SirBlaze10/Conversor-CC-CC-Buck-Boost-Interleaved/index.md

Neste projeto, foi efetuado o design, simulação, montagem e teste do protótipo de um Conversor CC-CC Bidirecional com Topologia Interleaved.

Na pasta PCB, encontra-se o esquemático e layout da placa de circuito impresso desenvolvida, tendo para tal fim sendo utilizado o PADS PCB Design Software da Mentor Graphics.

Na pasta Simulação PSIM, encontra-se a simulação do conversor com recurso ao software de simulação PSIM, desenvolvido pela Powersim inc., 
sendo que este possui inúmeras características indispensáveis para uma rigorosa simulação, desde uma biblioteca com um vasto número de componentes, 
até a possibilidade de criar algoritmos em linguagem C para sistemas de controlo.

Todo o código desenvolvido para o microprocessador utilizado (STM32F767ZIT6), encontra-se na pasta Código.

Todo o registo fotográfico, desde a bancada de teste, até à montagem do protótipo, encontra-se na pasta registo fotográfico.

Por fim, as duas apresentações públicas efetuadas no âmbito deste projeto, encontram-se na pasta apresentação, enquanto que o relatório do projeto encontra-se na pasta relatório.
