SirBlaze10/Conversor-CC-CC-Buck-Boost-Interleaved/Apresentação/Apresentação final PI.pdf

## UNIVERSIDADE DO MINHO

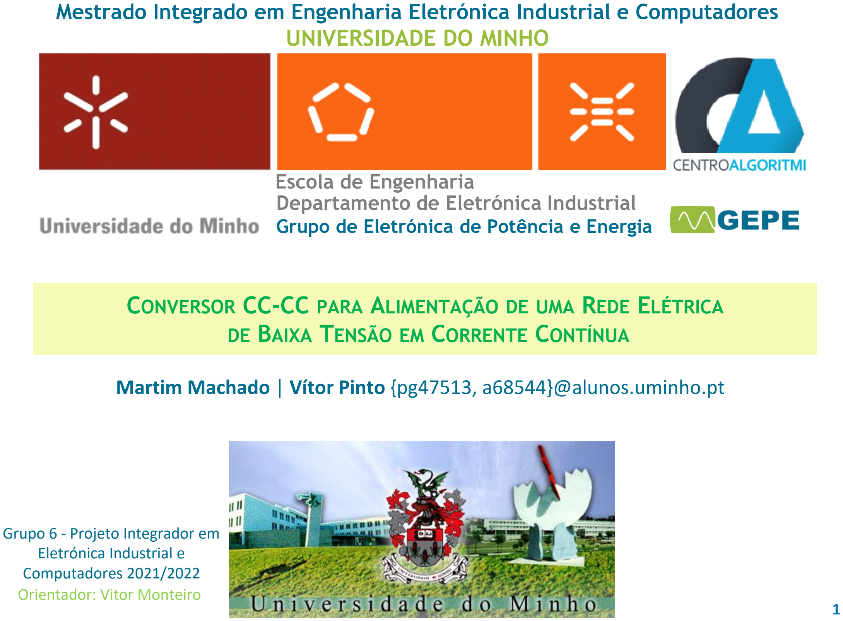
[picture p51: page 1]

Mestrado Integrado em Engenharia Eletrónica Industrial e Computadores

### Escola de Engenharia Departamento de Eletrónica Industrial

1

Grupo de Eletrónica de Potência e Energia

CONVERSOR CC-CC PARA ALIMENTAÇÃO DE UMA REDE ELÉTRICA DE BAIXA TENSÃO EM CORRENTE CONTÍNUA

## Martim Machado | Vítor Pinto {pg47513, a68544}@alunos.uminho.pt

Grupo 6 - Projeto Integrador em Eletrónica Industrial e
Computadores 2021/2022
Orientador: Vitor Monteiro

2

## ÍNDICE

## - Resumo e atualização das fases anteriores (análise e design)

## - Topologia Adotada - Simulações computacionais

## - Descrição dos detalhes de implementação relevantes

## - Implementação prática - Sistema de controlo (sensores, drivers, microprocessador, …) - Circuito de potência - Esquemático e design da placa para o sistema implementado - Montagem do protótipo

## - Apresentação e discussão de testes e resultados

## - Método de validação - Resultados em malha aberta - Resultados em malha fechada

## - Tarefas Realizadas - Conclusões do trabalho

3

# Componente teórica

4

## RESUMO E ATUALIZAÇÃO DAS FASES ANTERIORES (ANÁLISE E DESIGN)

## - Menor ripple corrente de saída - Correntes nas bobinas desfasados em 180° - Elevado rendimento

# - Topologia Adotada

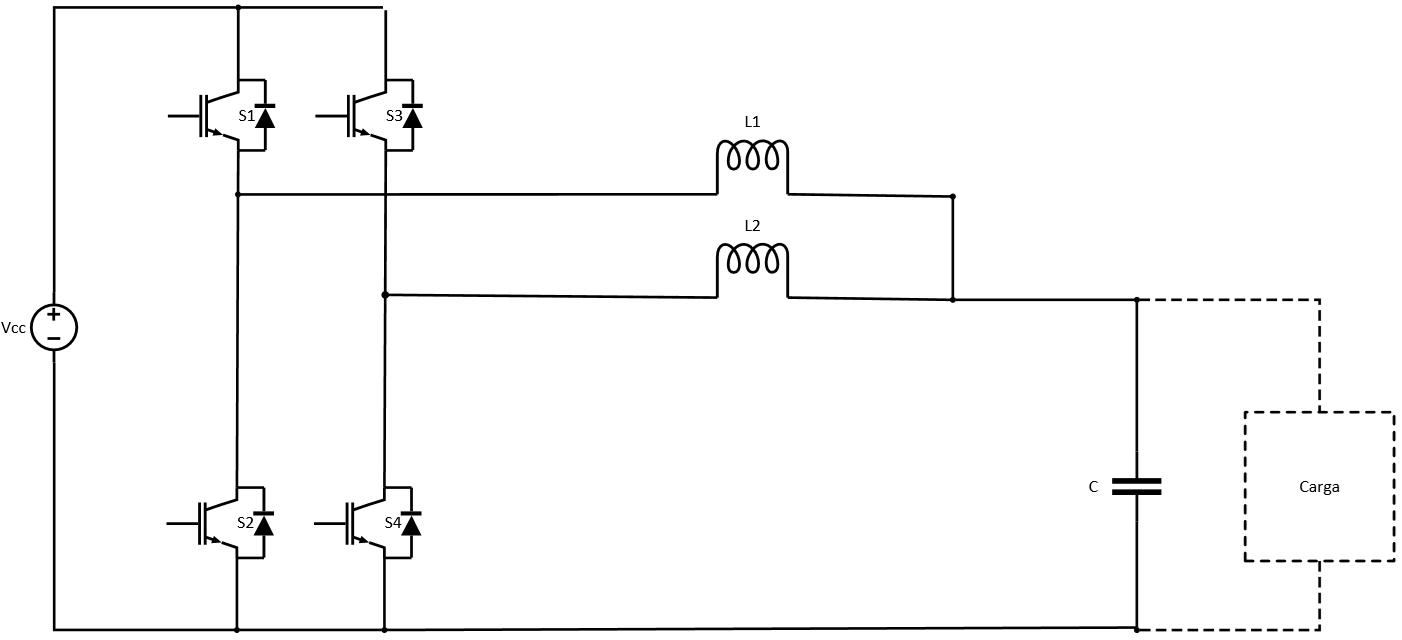
[picture p52: figure]

5

## RESUMO E ATUALIZAÇÃO DAS FASES ANTERIORES (ANÁLISE E DESIGN)

## - Peso e tamanho reduzidos

# - Topologia Adotada

## …foi usada uma bobina com núcleo com acoplamento mútuo…

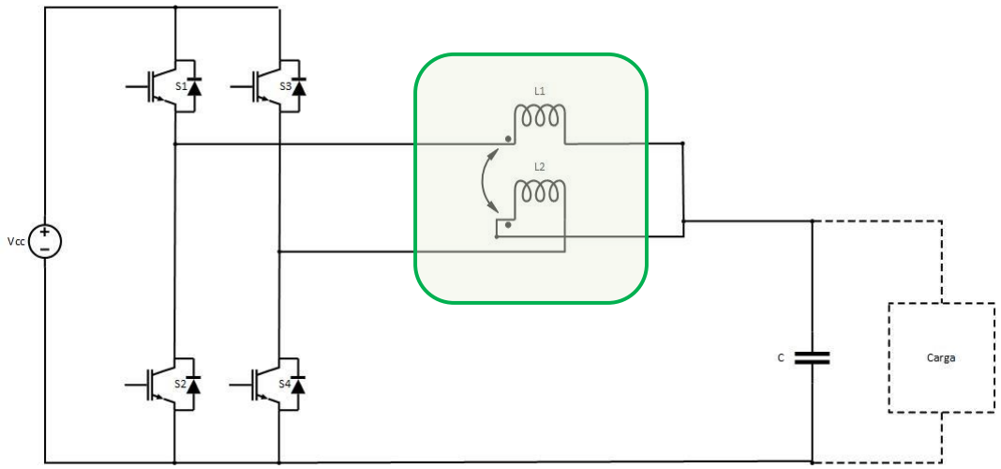
[picture p53: figure]

6

# Validação Computacional

## RESUMO E ATUALIZAÇÃO DAS FASES ANTERIORES (ANÁLISE E DESIGN)

# - Simulações computacionais

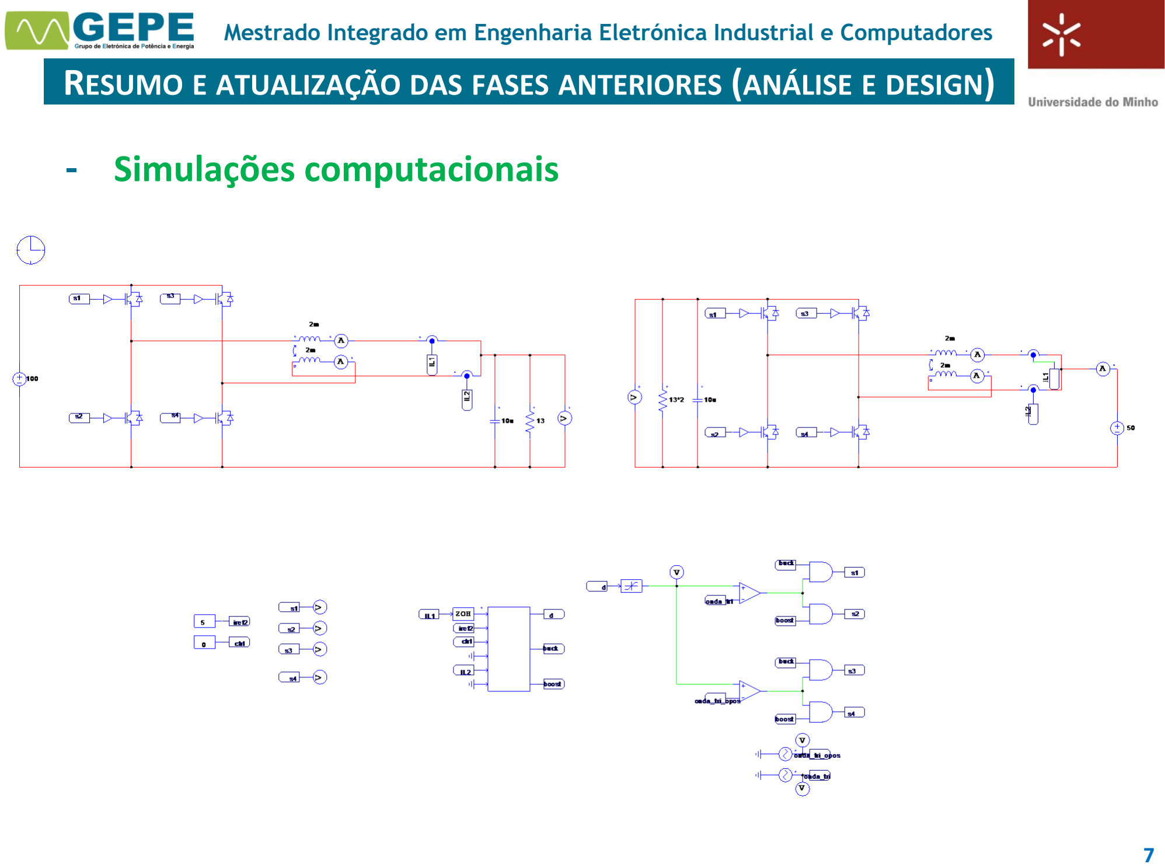
[picture p54: page 7]

7

8

## RESUMO E ATUALIZAÇÃO DAS FASES ANTERIORES (ANÁLISE E DESIGN)

## - Previsão comportamento do sistema/projeto - Maior segurança na validação experimental - Software utilizado: PSIM (Powersim Inc.) - Controlador PI

# - Simulações computacionais

## D = kp(iref − iL) + ki න( iref − iL)dt

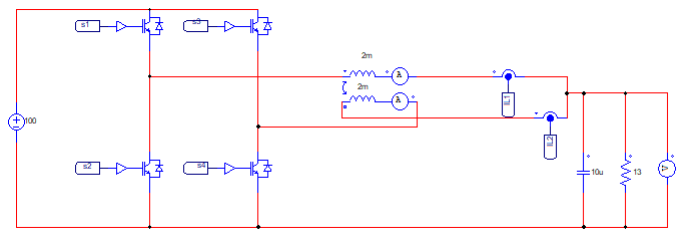
[picture p55: figure]

9

## RESUMO E ATUALIZAÇÃO DAS FASES ANTERIORES (ANÁLISE E DESIGN)

## - Previsão comportamento do sistema/projeto - Maior segurança na validação experimental - Software utilizado: PSIM (Powersim Inc.) - Controlador PI

# - Simulações computacionais

## …corrente em cada bobina controlada de forma individual…

10

## RESUMO E ATUALIZAÇÃO DAS FASES ANTERIORES (ANÁLISE E DESIGN)

## - Escrita de algoritmos em linguagem C - Simula o funcionamento do microprocessador

# - Simulações computacionais - Bloco C

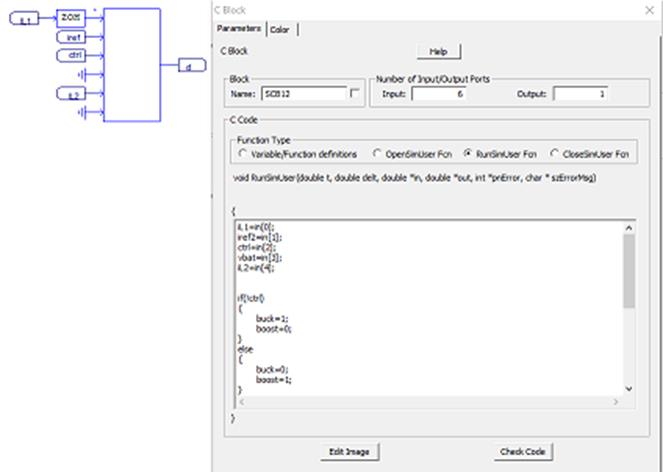
[picture p56: figure]

11

## RESUMO E ATUALIZAÇÃO DAS FASES ANTERIORES (ANÁLISE E DESIGN)

## - Lógica combinacional (selecionar buck ou boost) - Obtidos sinais de PWM desfasados em 180°

# - Simulações computacionais - Circuito de controlo

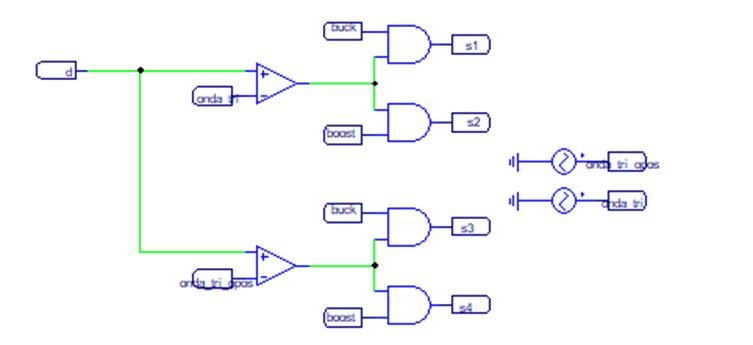
[picture p57: figure]

12

## RESUMO E ATUALIZAÇÃO DAS FASES ANTERIORES (ANÁLISE E DESIGN)

## - Frequência de amostragem 100 kHz - Frequência de comutação 50 kHz

# - Simulações computacionais - Sistema de controlo

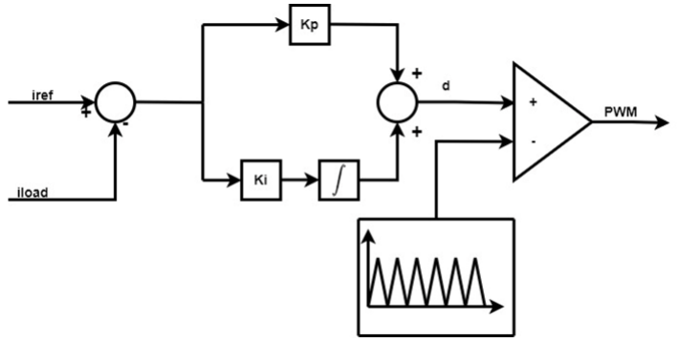
[picture p58: figure]

## RESUMO E ATUALIZAÇÃO DAS FASES ANTERIORES (ANÁLISE E DESIGN)

# - Simulações computacionais

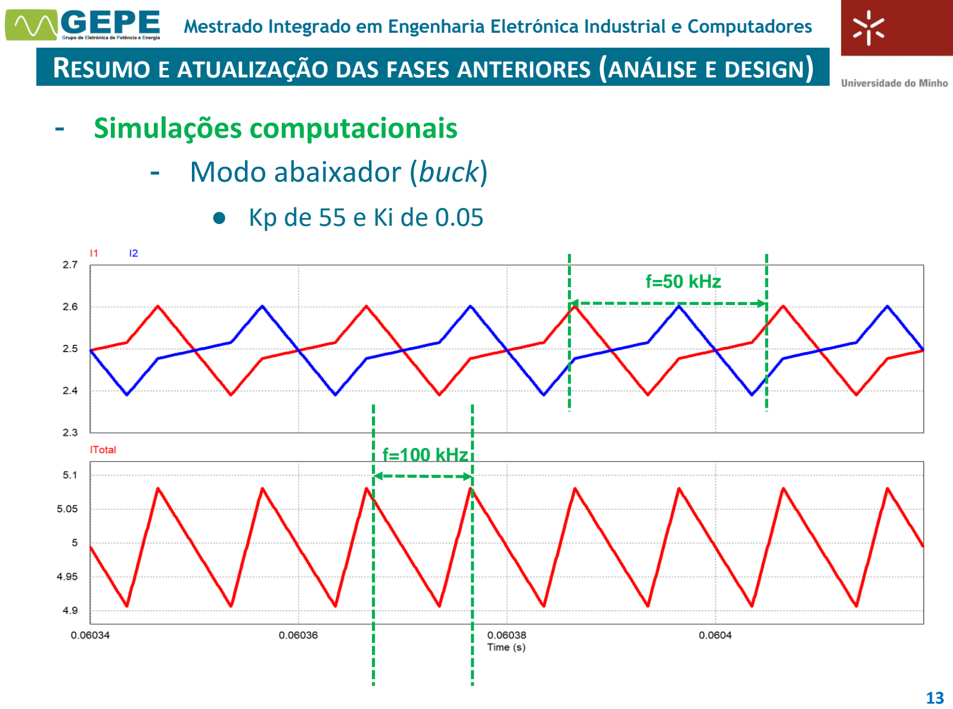
[picture p59: page 13]

13

## - Kp de 55 e Ki de 0.05

# - Modo abaixador (buck)

f=100 kHz

f=50 kHz

## RESUMO E ATUALIZAÇÃO DAS FASES ANTERIORES (ANÁLISE E DESIGN)

# - Simulações computacionais

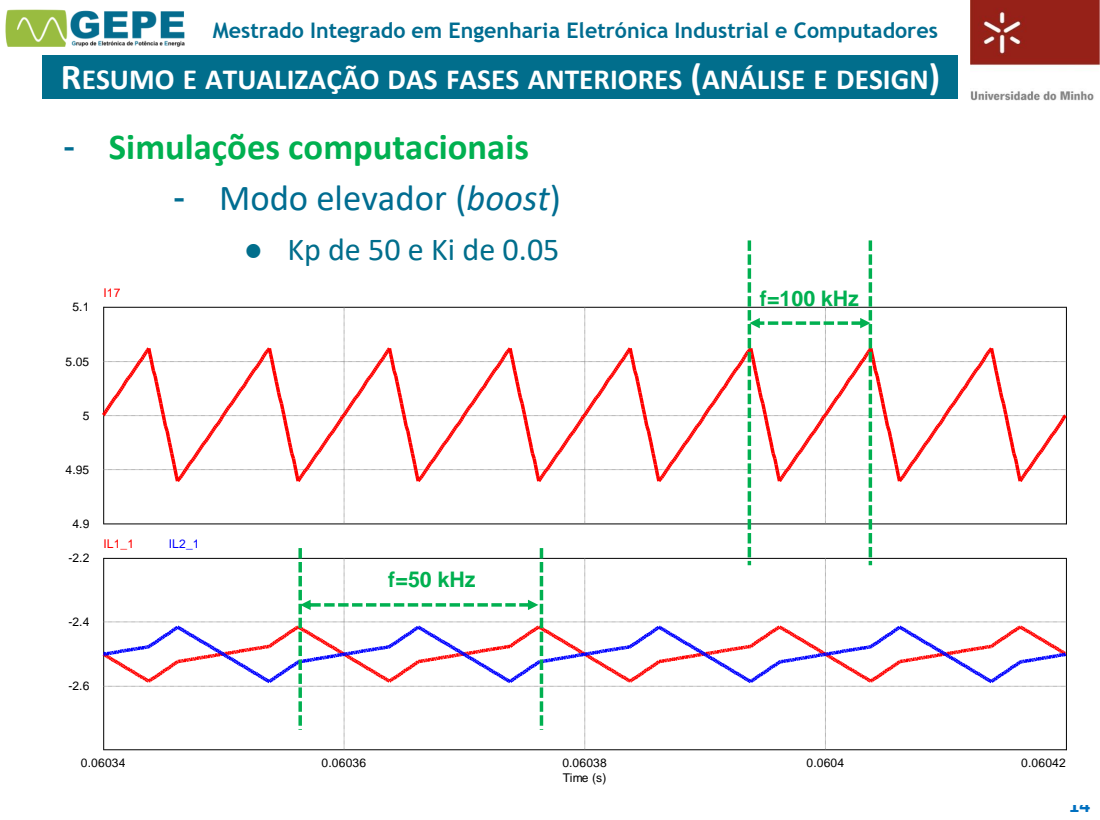
[picture p60: page 14]
Time (s); f=100 kHz; f=50 kHz

- Modo elevador (boost)

15

# Implementação Prática

## DESCRIÇÃO DOS DETALHES DE IMPLEMENTAÇÃO RELEVANTES

## - Sistema de controlo

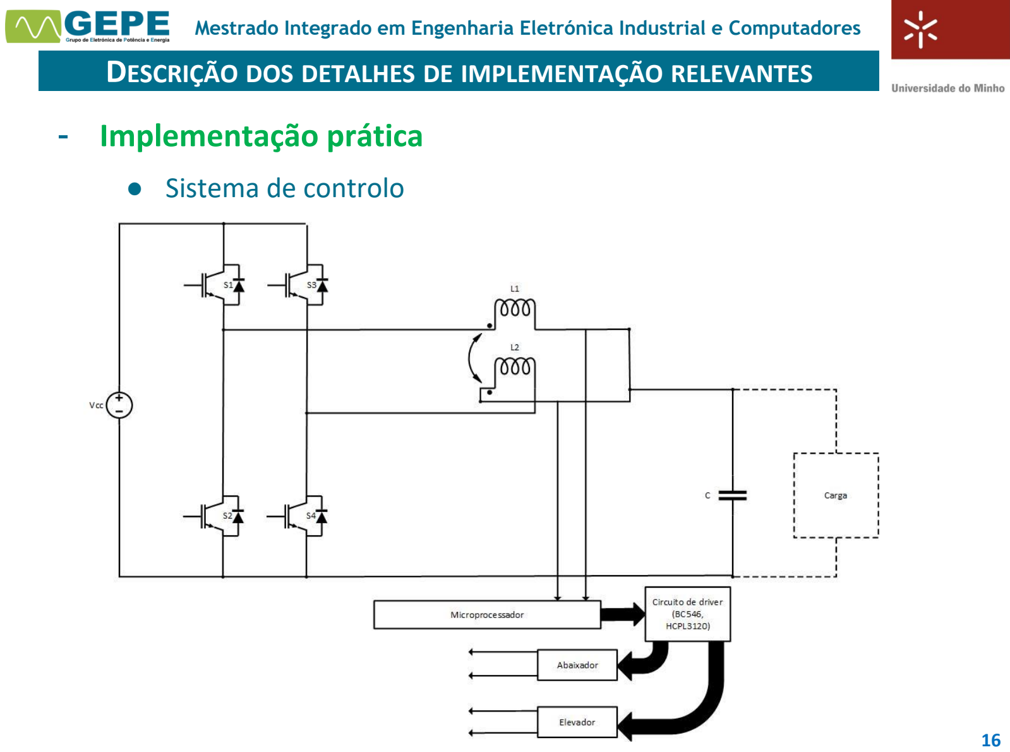
[picture p61: page 16]

16

## - Sistema de potência

# - Implementação prática

17

## DESCRIÇÃO DOS DETALHES DE IMPLEMENTAÇÃO RELEVANTES

## - Sensor efeito de Hall LA 100-P/SP13 - Medição de correntes CC e CA até 100 A - Corrente 1000 vezes inferior no secundário - 10 Ω < (R+Rm) < 65 Ω

# - Sistema de controlo - Sensores de corrente

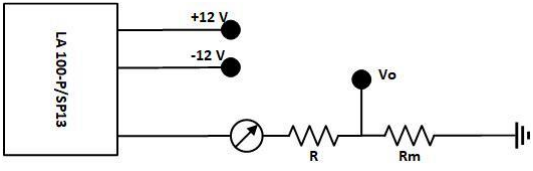
[picture p62: figure]

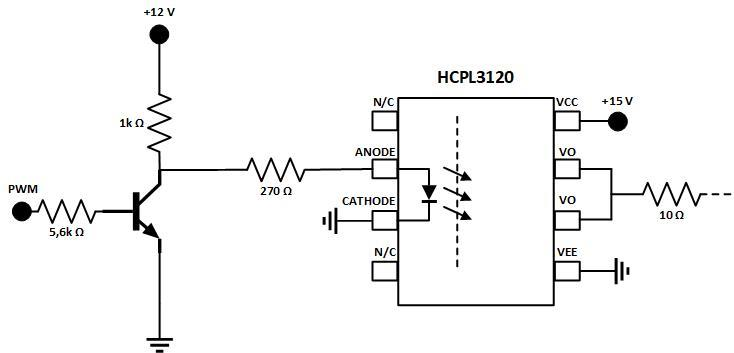
[picture p63: figure]

18

## DESCRIÇÃO DOS DETALHES DE IMPLEMENTAÇÃO RELEVANTES

## - Transístor bipolar BC546 - Optoacoplador HCPL3120 - Sinal de PWM com corrente de 10 mA (input HCPL3120) - Lógica inversora

# - Sistema de controlo - Circuito de driver

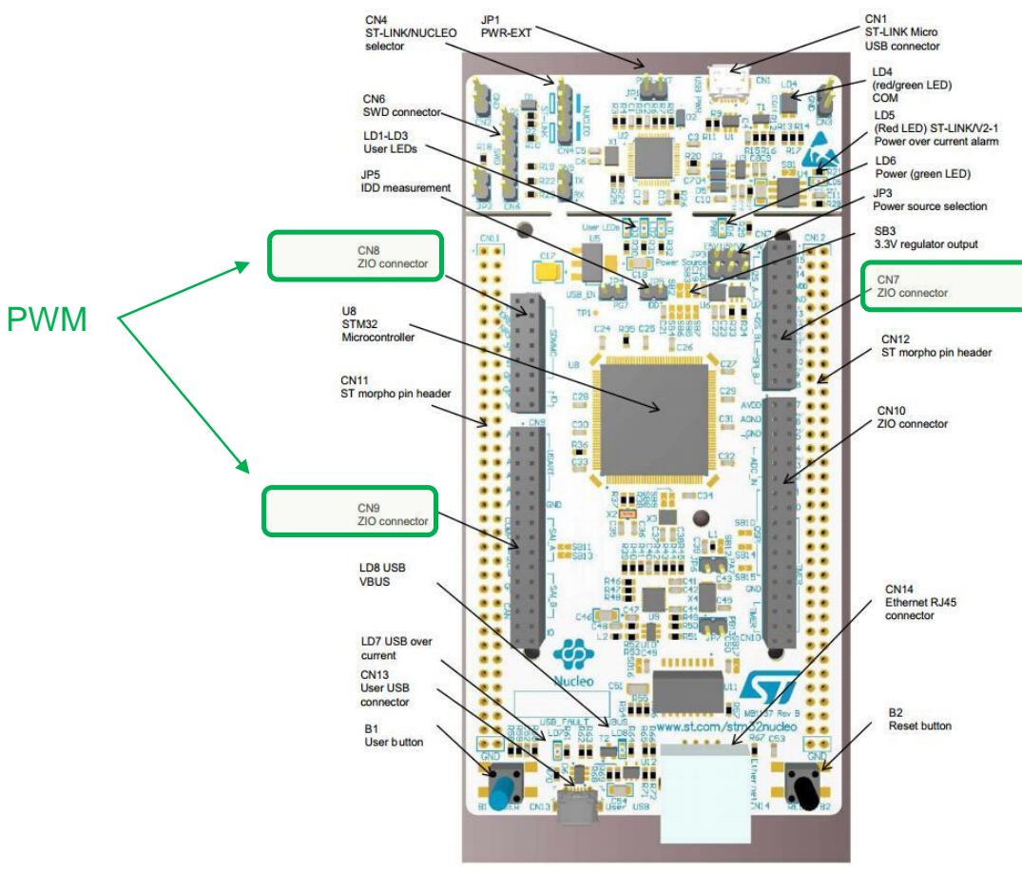
[picture p64: figure]
PWM

19

## DESCRIÇÃO DOS DETALHES DE IMPLEMENTAÇÃO RELEVANTES

# - Microprocessador - STM32F767ZIT6

ADC


20

## DESCRIÇÃO DOS DETALHES DE IMPLEMENTAÇÃO RELEVANTES

# - Sistema de controlo - Fluxograma da rotina de controlo

21

## DESCRIÇÃO DOS DETALHES DE IMPLEMENTAÇÃO RELEVANTES

# - Circuito de potência

## - IGBT com referência FGA25N120AN - Bobinas de acoplamento mútuo de 2 mH | 20 A - Colocação de dissipador (10 cm x 10 cm) - Condensadores de 15 µF 800 V - Tensão input máxima: 150 V - Tensão output máxima: 150 V - Potência máxima: 2,4 kW

## DESCRIÇÃO DOS DETALHES DE IMPLEMENTAÇÃO RELEVANTES

# - Esquemático e Design da Placa para o Sistema Implementado

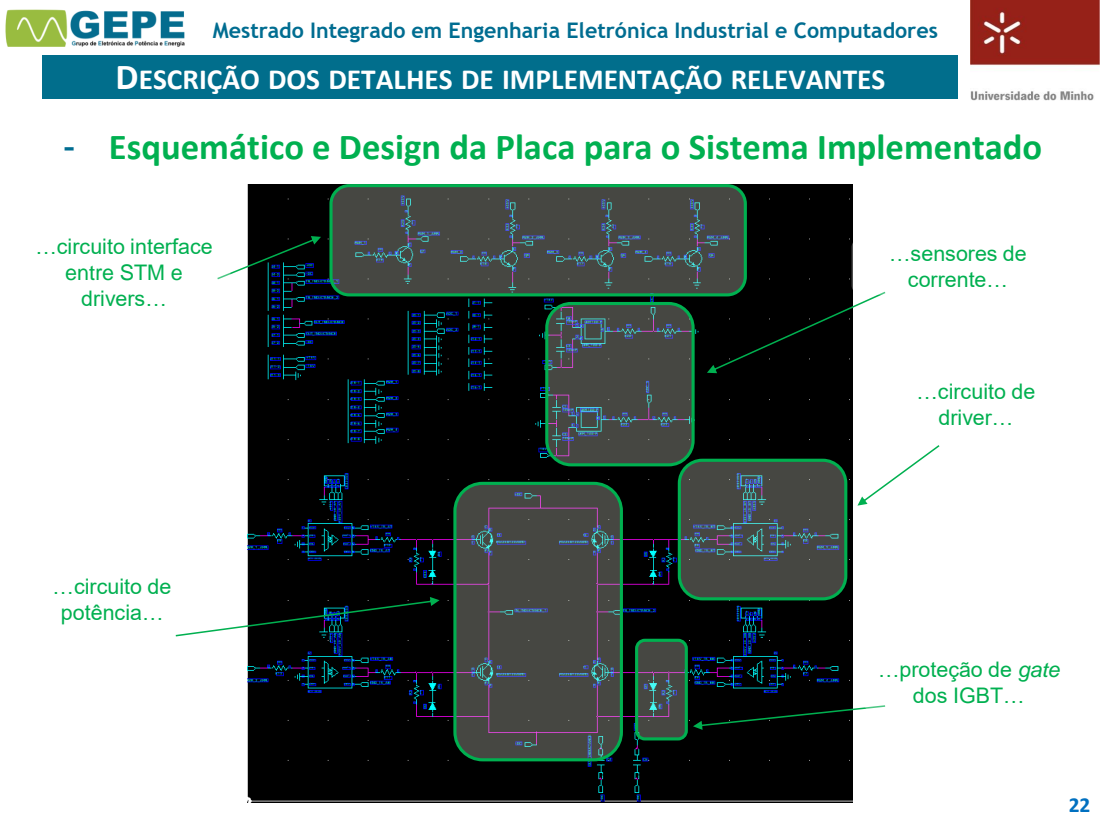
[picture p65: page 22]
…circuito de driver…; …sensores de corrente…; …circuito interface entre STM e drivers…; …circuito de potência…

…proteção de gate
dos IGBT…

## DESCRIÇÃO DOS DETALHES DE IMPLEMENTAÇÃO RELEVANTES

- Esquemático e Design da Placa para o Sistema Implementado Sistema de controlo Circuito de potência

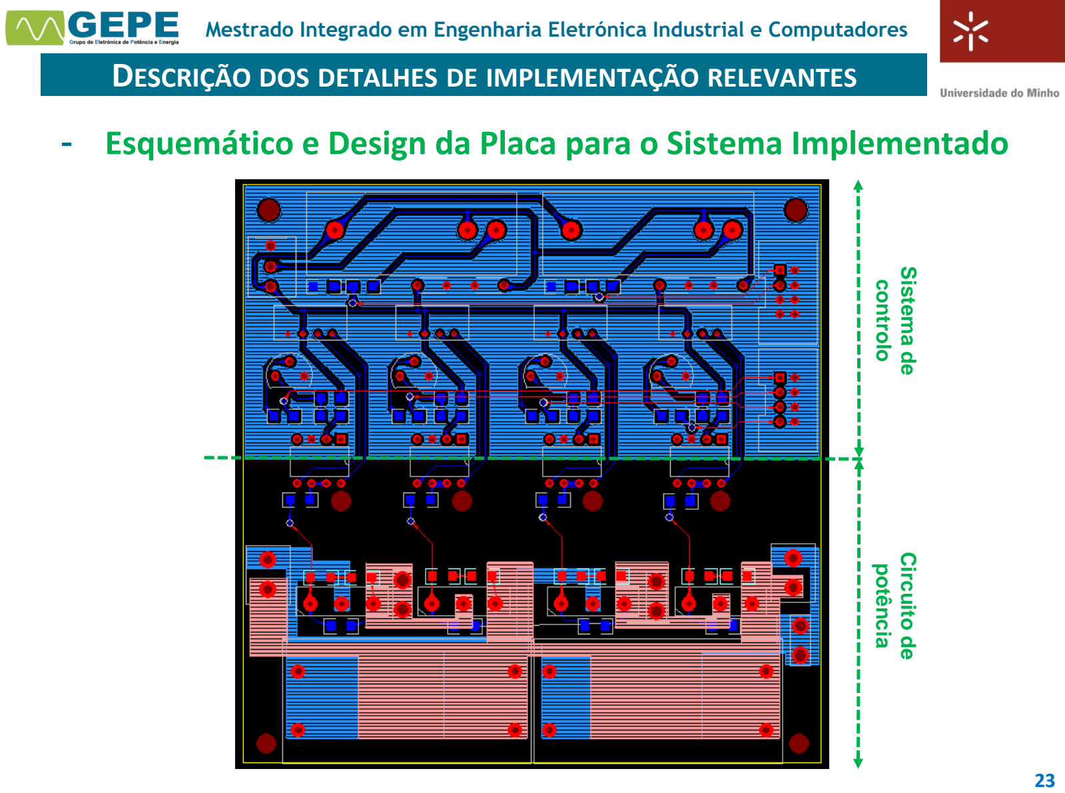
[picture p66: page 23]

23

## DESCRIÇÃO DOS DETALHES DE IMPLEMENTAÇÃO RELEVANTES

# - PCB desenvolvido

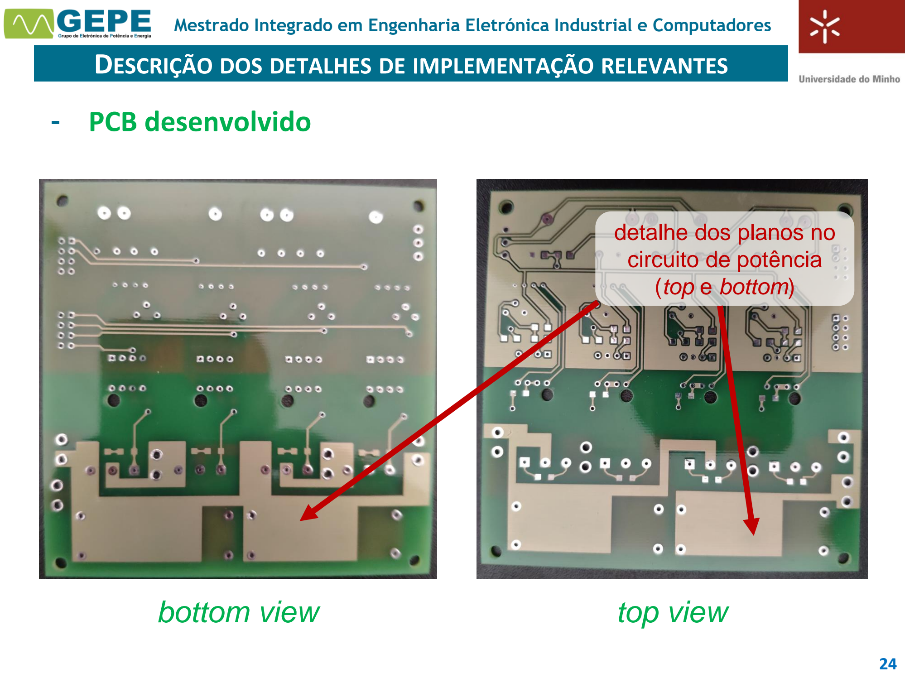
[picture p67: page 24]

24

bottom view | top view

## detalhe dos planos no circuito de potência (top e bottom)

## DESCRIÇÃO DOS DETALHES DE IMPLEMENTAÇÃO RELEVANTES

# - Montagem do protótipo

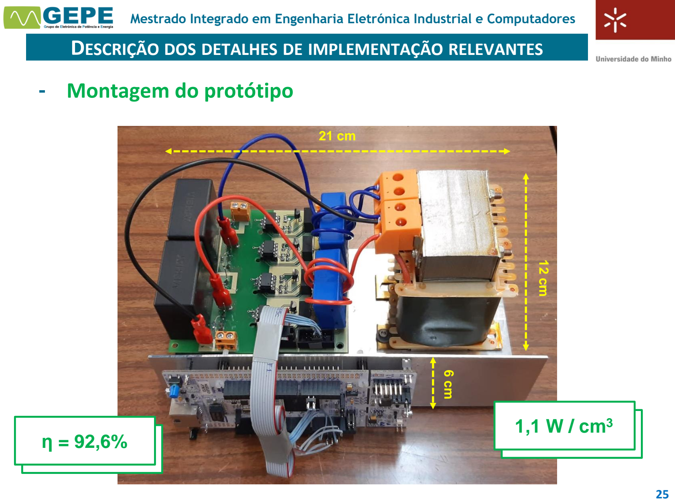
[picture p68: page 25]

25

### 21 cm

### 12 cm

### 6 cm

## 1,1 W / cm³

η = 92,6%

## DESCRIÇÃO DOS DETALHES DE IMPLEMENTAÇÃO RELEVANTES

# - Montagem do protótipo …circuito de driver

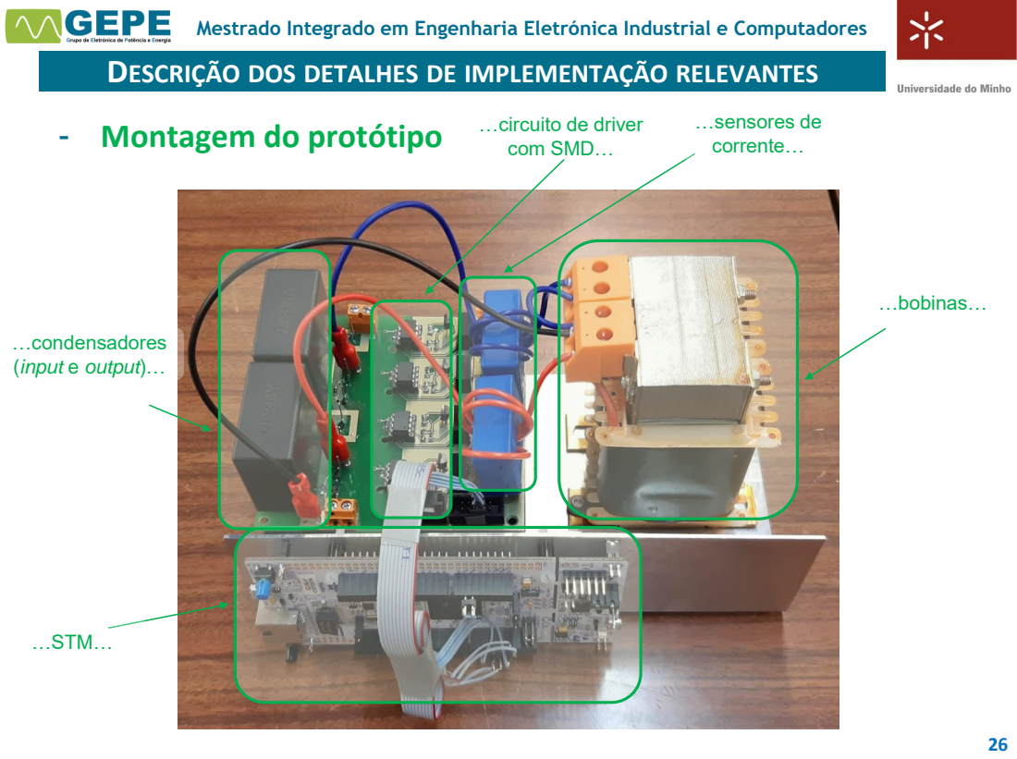
[picture p69: page 26]
com SMD…; …bobinas…; …sensores de corrente…; …STM…; …condensadores (input e output)…

## DESCRIÇÃO DOS DETALHES DE IMPLEMENTAÇÃO RELEVANTES

# - Montagem do protótipo

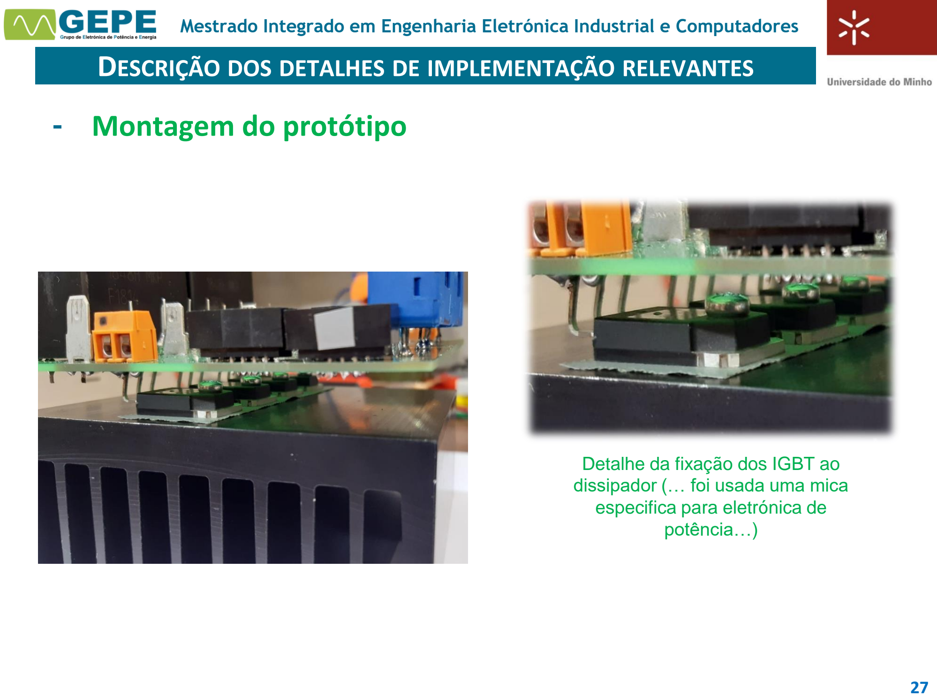
[picture p70: page 27]

27

Detalhe da fixação dos IGBT ao dissipador (… foi usada uma mica especifica para eletrónica de potência…)

## APRESENTAÇÃO DE TESTES E RESULTADOS

# - Montagem do protótipo (setup da bancada de trabalho)

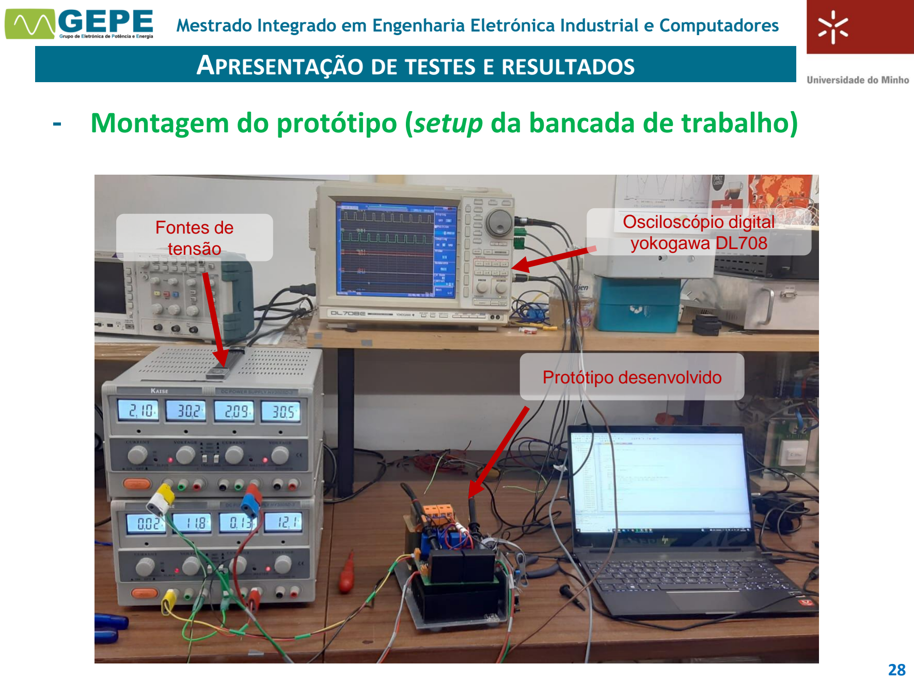
[picture p71: page 28]

28

Osciloscópio digital
yokogawa DL708

Protótipo desenvolvido

Fontes de
tensão

29

# Validação Experimental

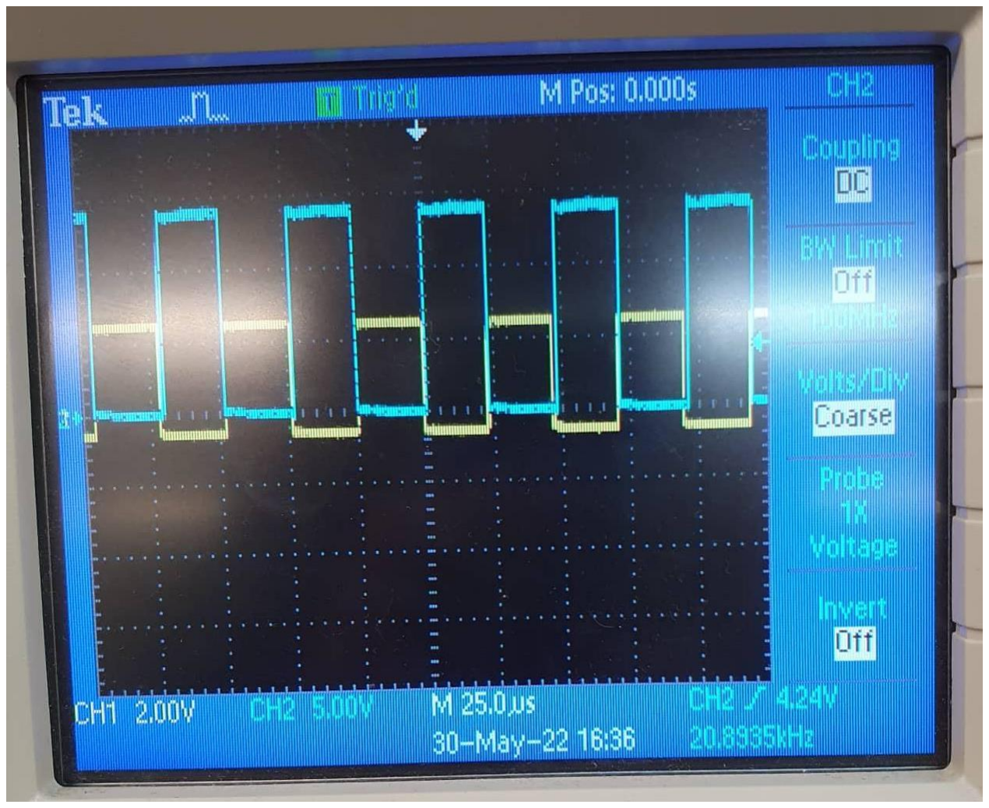
[picture p72: figure]

30

## APRESENTAÇÃO DE TESTES E RESULTADOS

# - Método de validação

## - Validação do sistema de controlo - Resultados em malha aberta - Resultados em malha fechada

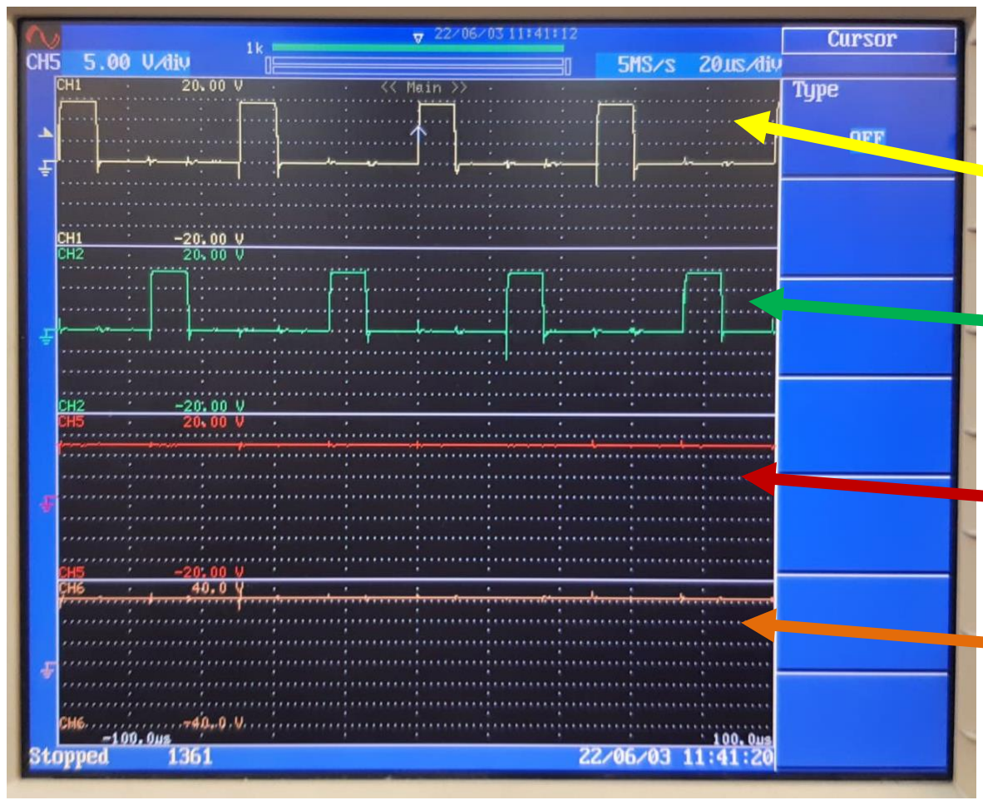
[picture p73: figure]

31

## APRESENTAÇÃO DE TESTES E RESULTADOS

# - Resultados em malha aberta

## - Modo abaixador (buck) - Duty-cycle não variável de 25% - Frequência de comutação 20 kHz

### vin: 30 V [10 V/div]

### vout: 12 V [5 V/div]

### vge1: 15 V [5 V/div]

### vge2: 15 V [5 V/div]

## APRESENTAÇÃO DE TESTES E RESULTADOS

# - Resultados em malha aberta

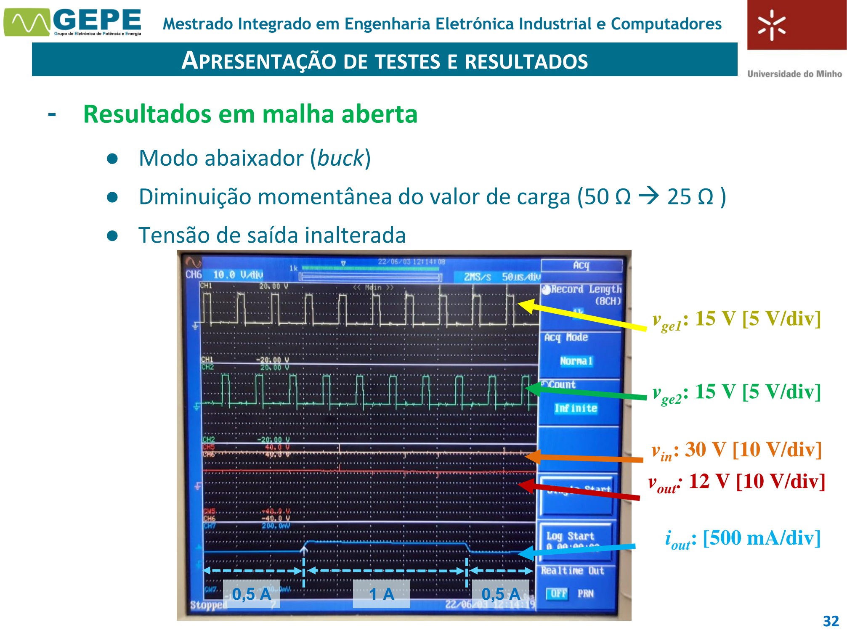
[picture p74: page 32]

32

## - Modo abaixador (buck) - Diminuição momentânea do valor de carga (50 Ω → 25 Ω ) - Tensão de saída inalterada

### iout: [500 mA/div]

### vout: 12 V [10 V/div]

### vge1: 15 V [5 V/div]

### vge2: 15 V [5 V/div]

### vin: 30 V [10 V/div]

0,5 A | 1 A | 0,5 A

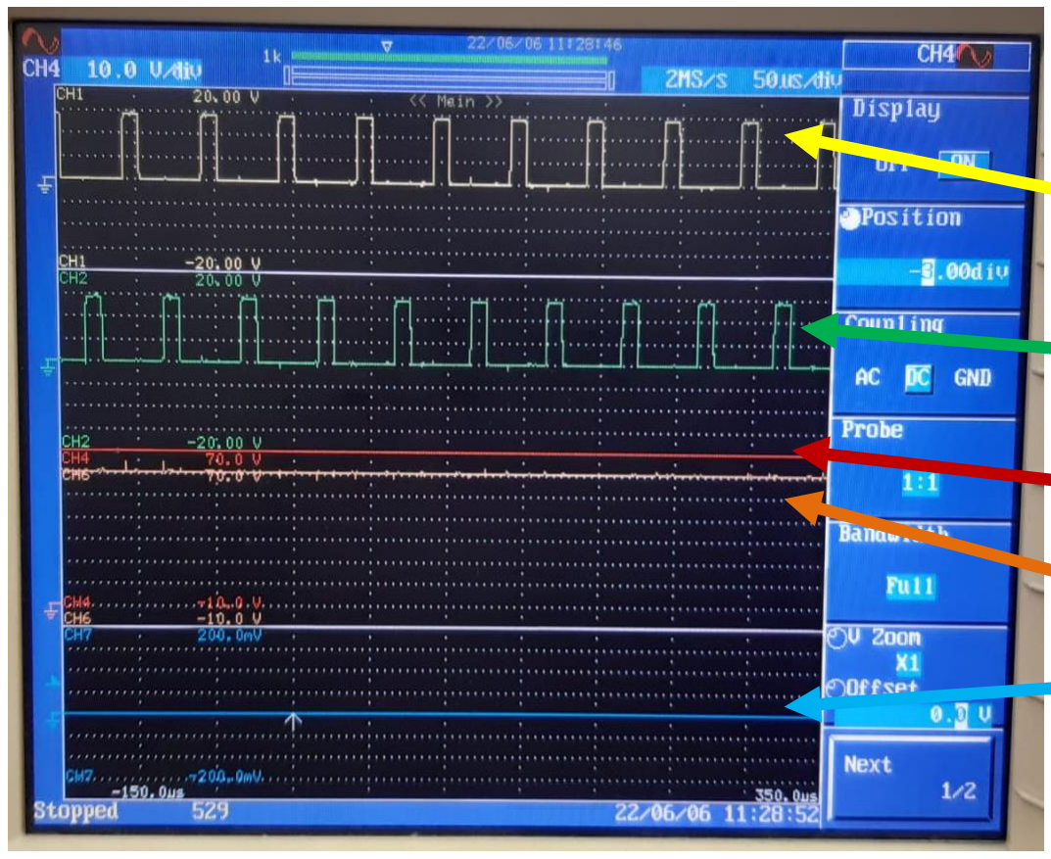
[picture p75: figure]

33

## APRESENTAÇÃO DE TESTES E RESULTADOS

# - Resultados em malha aberta

## - Modo elevador (boost) - Duty-cycle não variável de 25% - Frequência de comutação 20 kHz

### iout: [500 mA/div]

### vout: 70 V [10 V/div]

### vge1: 15 V [5 V/div]

### vge2: 15 V [5 V/div]

### vin: 60 V [10 V/div]

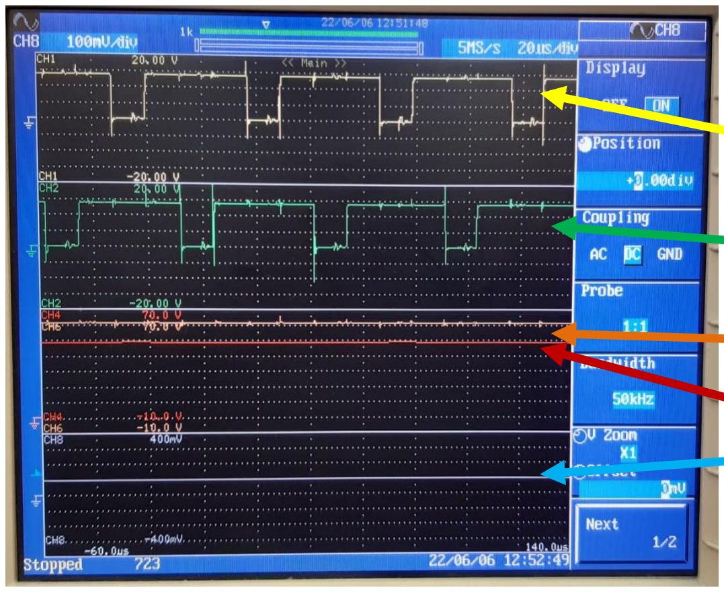
[picture p76: figure]

34

## APRESENTAÇÃO DE TESTES E RESULTADOS

# - Resultados em malha fechada

## - Modo abaixador (buck) - Ganhos Kp de 10 e Ki de 0.1 - Corrente de referência 1 A

### iout: 1 A [1 A/div]

### vout: 50 V [10 V/div]

### vge1: 15 V [5 V/div]

### vge2: 15 V [5 V/div]

### vin: 60 V [10 V/div]

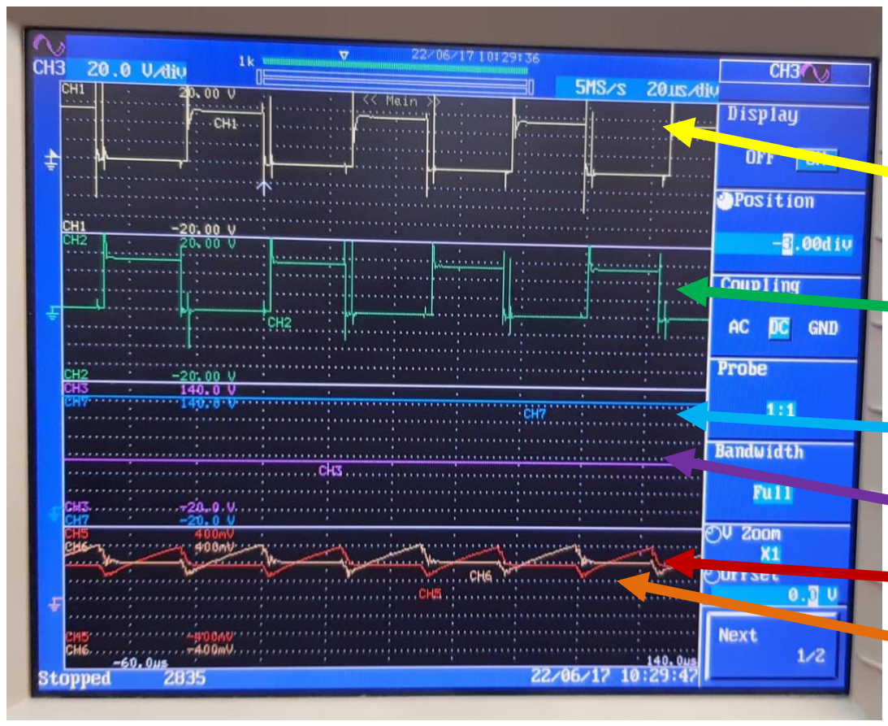
[picture p77: figure]

35

## APRESENTAÇÃO DE TESTES E RESULTADOS

# - Resultados em malha fechada

## - Modo abaixador (buck) - Ganhos Kp de 10 e Ki de 0.1 - Corrente de referência 4 A

### iout: 2 A [1 A/div]

### vout: 60 V [20 V/div]

### vge1: 15 V [5 V/div]

### vge2: 15 V [5 V/div]

### vin: 120 V [20 V/div]

### iout: 2 A [1 A/div]

36

# Tarefas Realizadas e Conclusões

37

## TAREFAS REALIZADAS

### - ESTUDO DO ESTADO DE ARTE

## repositoriUM, artigos científicos, dissertações, teses de doutoramento,…

### - SIMULAÇÕES COMPUTACIONAIS EM PSIM

## modelo preliminar e final em malha aberta / fechada, modo buck / boost

### - PROJETO DE PCB EM PADS

## esquemático e layout para eletrónica de potência, planos, isolamentos,…

### - IMPLEMENTAÇÃO PRÁTICA LABORATORIAL

## solda de componentes SMD, calibração sensores,…

### - RESULTADOS EXPERIMENTAIS

## malha aberta e malha fechada, modo buck e modo boost,…

38

## CONCLUSÕES

## - A escassez de recursos não renováveis tem fomentado o aparecimento de novas fontes de energia renováveis

## - Face a este contexto, são necessários novos métodos de transmissão de energia e um novo paradigma das redes elétricas inteligentes

## - Neste âmbito foi desenvolvido um conversor CC-CC bidirecional do tipo interleaved

## - Inicialmente foi efetuado um estudo do conversor a implementar e foram realizadas simulações computacionais

## - Posteriormente foi projetado e implementado um PCB de eletrónica de potência (incluindo sensores, microprocessador,…)

## - Por fim, foram obtidos resultados experimentais em laboratório com o protótipo desenvolvido

## - No âmbito do trabalho foram adquiridas competências pessoais em vários domínios (eletrónica de potência, controlo digital, PWM…)

39

# Obrigado pela vossa atenção!

# FIM
