SirBlaze10/Conversor-CC-CC-Buck-Boost-Interleaved/Pcb/Esquemático.PNG

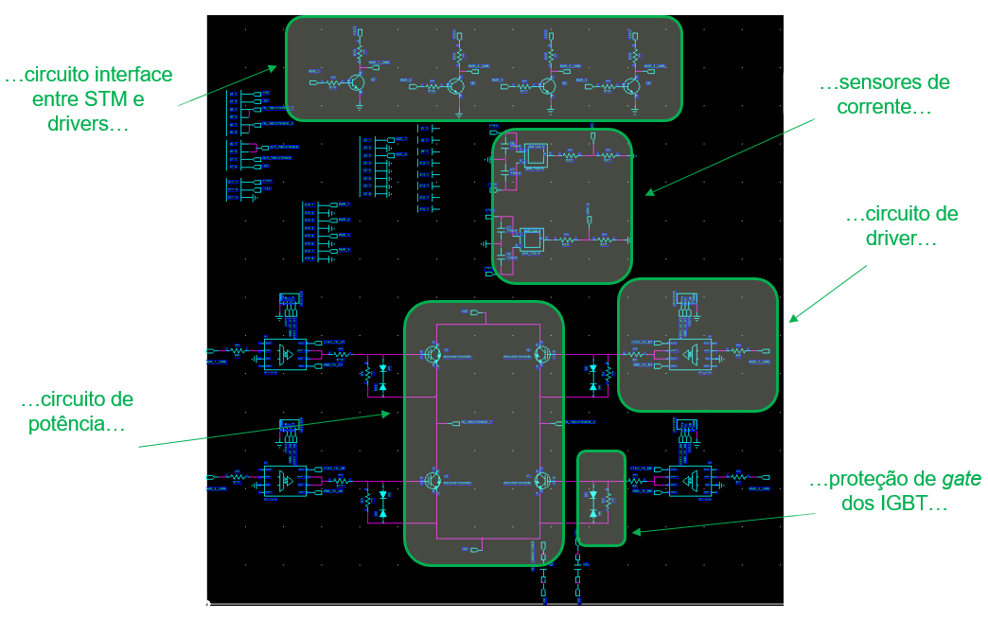
Pcb/Esquemático.PNG
