SirBlaze10/Conversor-CC-CC-Buck-Boost-Interleaved/Pcb/Layout.PNG

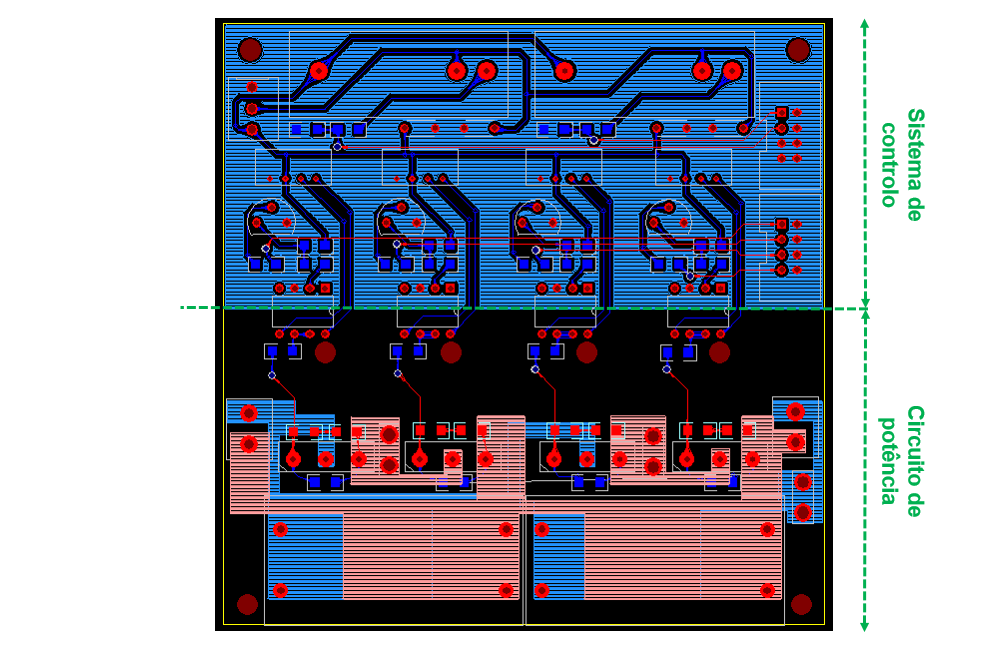
Pcb/Layout.PNG
