SirBlaze10/Conversor-CC-CC-Buck-Boost-Interleaved/Registo fotográfico prototipo desensolvido/Bancada de trabalho (2).jpeg

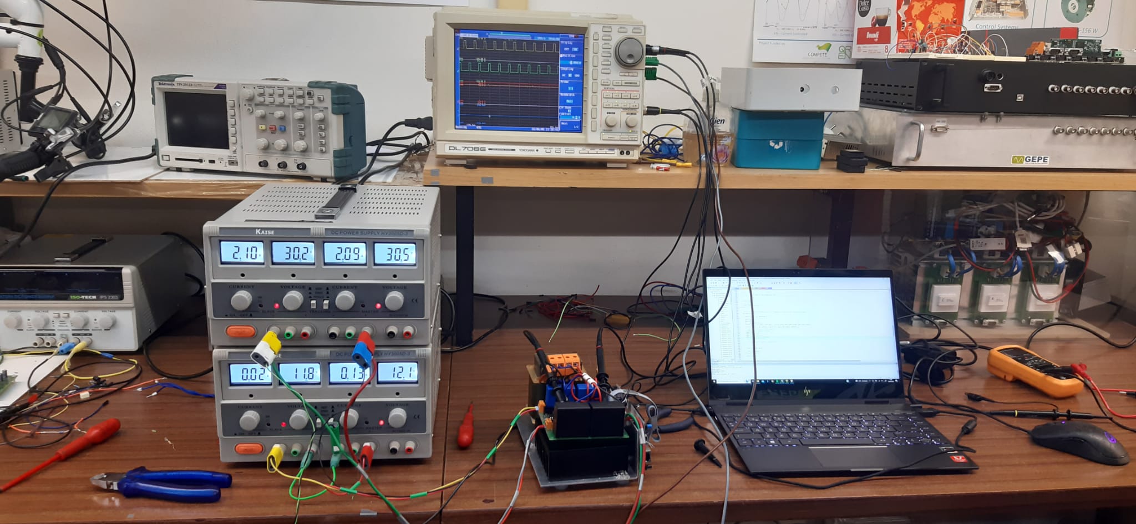
Registo fotográfico prototipo desensolvido/Bancada de trabalho (2).jpeg
