SirBlaze10/Conversor-CC-CC-Buck-Boost-Interleaved/Registo fotográfico prototipo desensolvido/leftovers (2).jpeg

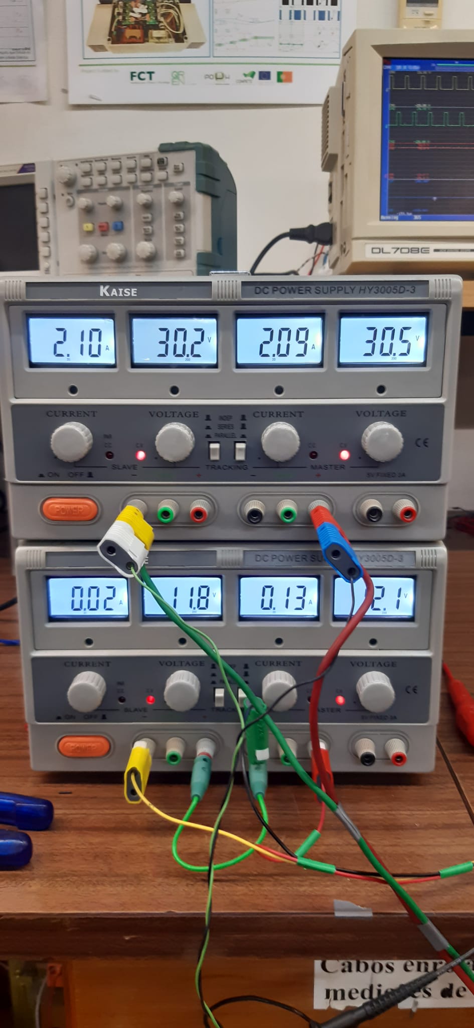
Registo fotográfico prototipo desensolvido/leftovers (2).jpeg
