SirBlaze10/Conversor-CC-CC-Buck-Boost-Interleaved/Registo fotográfico prototipo desensolvido/Pcb com heatsink.jpeg

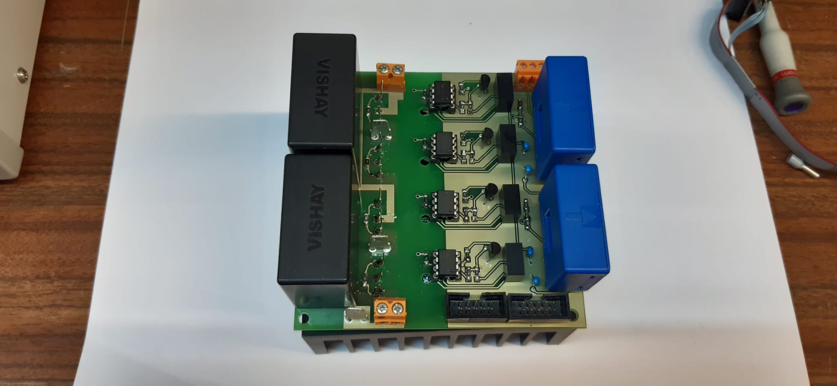
Registo fotográfico prototipo desensolvido/Pcb com heatsink.jpeg
