SirBlaze10/Conversor-CC-CC-Buck-Boost-Interleaved/Registo fotográfico prototipo desensolvido/Prototipo final.jpeg

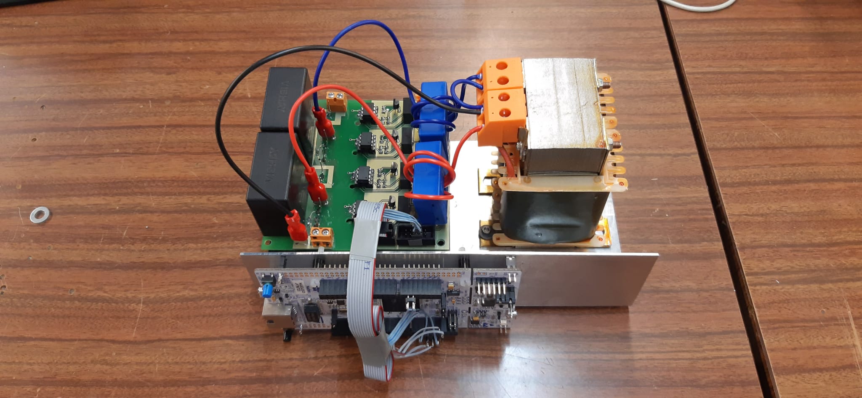
Registo fotográfico prototipo desensolvido/Prototipo final.jpeg
