SirBlaze10/Conversor-CC-CC-Buck-Boost-Interleaved/Registo fotográfico prototipo desensolvido/Resultados práticos (1).jpeg

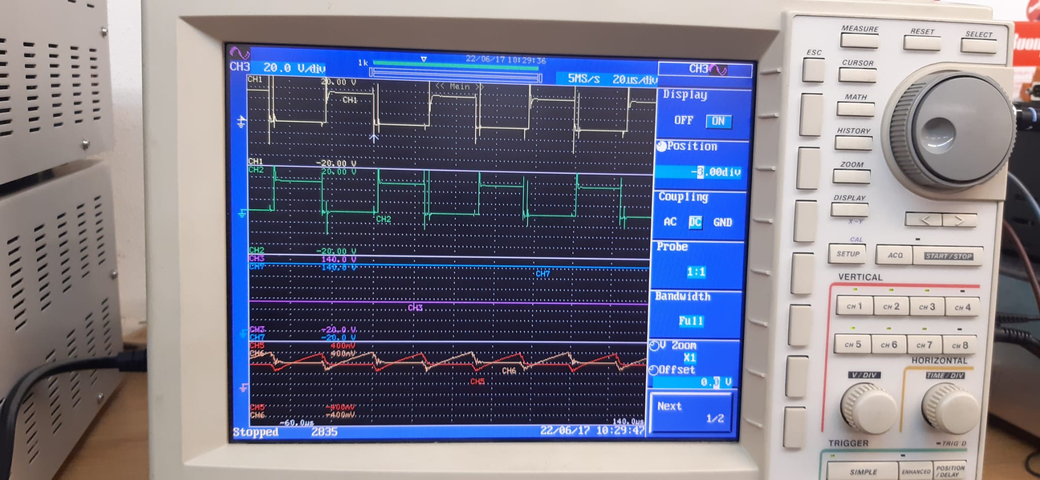
Registo fotográfico prototipo desensolvido/Resultados práticos (1).jpeg
