SirBlaze10/Conversor-CC-CC-Buck-Boost-Interleaved/Registo fotográfico prototipo desensolvido/Resultados práticos (6).jpeg

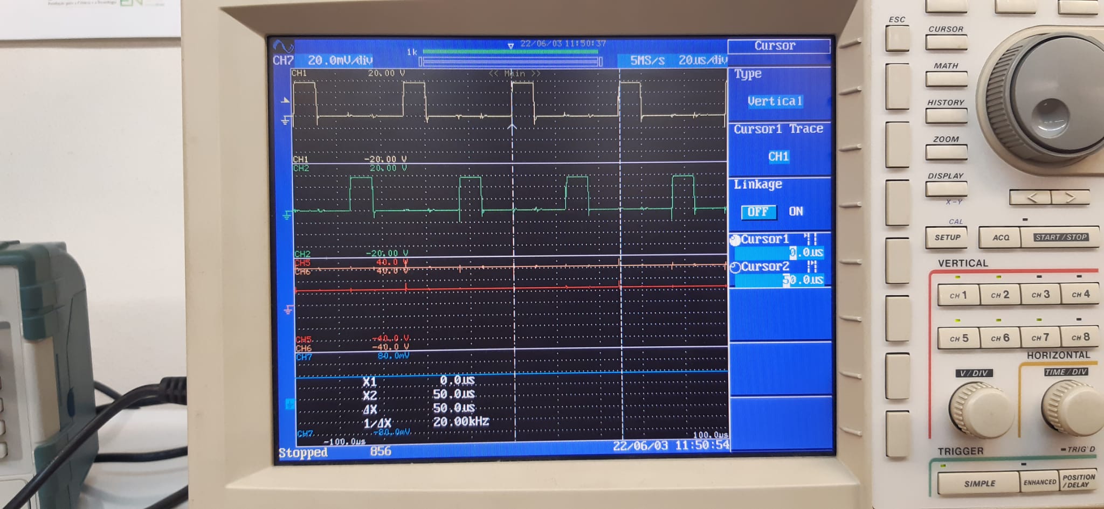
Registo fotográfico prototipo desensolvido/Resultados práticos (6).jpeg
