SirBlaze10/Conversor-CC-CC-Buck-Boost-Interleaved/Registo fotográfico prototipo desensolvido/Resultados práticos (12).jpeg

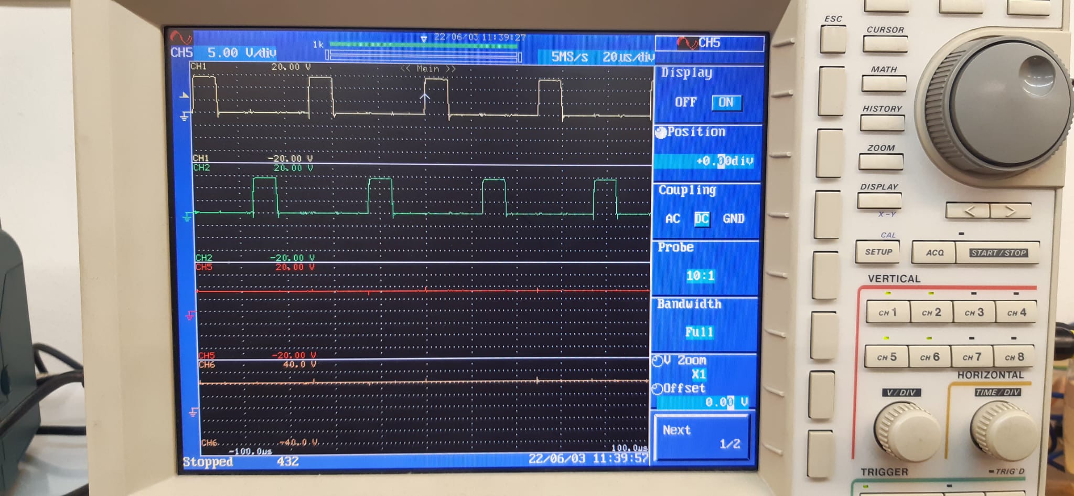
Registo fotográfico prototipo desensolvido/Resultados práticos (12).jpeg
