SirBlaze10/Conversor-CC-CC-Buck-Boost-Interleaved/(list of files, drawings)

Other design files:
Pcb/default4.pcb
