SirBlaze10/Conversor-CC-CC-Buck-Boost-Interleaved/Código/Core/Src/main.c

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
/* Includes ------------------------------------------------------------------*/
#include "main.h"
#include "adc.h"
#include "tim.h"
#include "usart.h"
#include "gpio.h"

/* USER CODE BEGIN Includes */
#include "stdio.h"
#include "string.h"
#include "math.h"
#include "commands.h"
#include "dutyinterleaved.h"
/* USER CODE END Includes */

/* USER CODE BEGIN PD */
#define PI 3.141592
#define SIN_RES 100
/* USER CODE END PD */


void SystemClock_Config(void);
/**
  * @brief  The application entry point.
  * @retval int
  */
int main(void)
{
  /* USER CODE BEGIN 1 */
//		uint32_t counter = 0;
  /* USER CODE END 1 */

  /* MCU Configuration--------------------------------------------------------*/

  /* Reset of all peripherals, Initializes the Flash interface and the Systick. */
  HAL_Init();

  /* Configure the system clock */
  SystemClock_Config();

  /* Initialize all configured peripherals */
  MX_GPIO_Init();
  MX_USART3_UART_Init();
  MX_ADC1_Init();
  MX_TIM7_Init();
  MX_ADC2_Init();
  MX_TIM4_Init();
  MX_TIM3_Init();
  /* USER CODE BEGIN 2 */
	
	init_UART3();	
		
	HAL_ADC_Start_IT(&hadc1);	//reativar a interrupçao do ADC 
		
	HAL_ADC_Start_IT(&hadc2); //reativar a interrupçao do ADC 
		
//		EPLL_calc();
//		harm = epll.voltageOUT - epll.voltageIN;
//		
//		//TIM1->CCR1 = (uint16_t)((((harm/54.54)+3.3/2)*(4095/3.3))*TIM_RATIO2);
//		
//		if(epll.voltageOUT>=0)
//		{	TIM1->CCR1 = (uint16_t)((epll.voltageOUT/50)*2159);			//90 é o valor maximo (+/-) //2159 é o valor maximo de pwm
//			TIM1->CCR2 = 0;
//		}
//		else
//		{	
//			TIM1->CCR1 = 0;
//			TIM1->CCR2 = -(int16_t)((epll.voltageOUT/50)*2159);			//90 é o valor maximo (+/-) //2159 é o valor maximo de pwm
//			
//		}
	
			//inicializaçao timer3, Responsavel pelo PWM
		HAL_TIM_PWM_Start(&htim3, TIM_CHANNEL_1);
		HAL_TIM_PWM_Start(&htim3, TIM_CHANNEL_2);
		//inicializaçao do DAC e timer7
			HAL_TIM_Base_Start(&htim7);
		
		//inicializaçao timer4, Responsavel pelo PWM
		HAL_TIM_PWM_Start(&htim4, TIM_CHANNEL_1);
		HAL_TIM_PWM_Start(&htim4, TIM_CHANNEL_2);
		HAL_TIM_PWM_Start(&htim4, TIM_CHANNEL_3);
		
		//TIM1->CCR1 = 0;
		//____________ Codigo de Experimentaçao _____________________________


		
		//____________ Codigo de Experimentaçao FIM _____________________________
		
		
		
  /* USER CODE END 2 */

  /* Infinite loop */
  /* USER CODE BEGIN WHILE */
  while (1)
  {
				
		//verifica sempre se recebeu carater e responde (o check é feito dentro da funçao)
		Rx_char_parsing();
    
		if(ADC1Flag == 1 && ADC2Flag == 1)
		{
			ADC1Flag = 0;
			ADC2Flag = 0;
			duty_cycle_buck_calc();
			printf("duty = %f; ADC1 = %d, ADC2 = %d\r\n",duty, ADC1_chn4_value, ADC2_chn5_value);
			//printf("ADC1 = %d; Sensor1 = %f A\r\n", ADC1_chn4_value, sensorI_1);
			//printf("ADC2 = %d; Sensor2 = %f A\r\n", ADC2_chn5_value, sensorI_2);
//			TIM4->CCR1 = (uint16_t)(duty*10800);
			TIM4->CCR1 = 0.25*2700;
			TIM4->CCR2 = 2700-(0.25*2700);
//			TIM3->CCR1 = 2700;
//			TIM3->CCR2 = 0;
//			if(TIM4->CNT == 65535)
//			{
//				TIM4->CCR3 = (uint16_t)(duty*10800);
//			}
		}
			
    /* USER CODE END WHILE */

    /* USER CODE BEGIN 3 */
	}//fim do while(1)
	
  /* USER CODE END 3 */
}

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
