SirBlaze10/Conversor-CC-CC-Buck-Boost-Interleaved/Código/Interface_PL1.ioc

Mcu.UserName=STM32F767ZITx
PA13.Signal=SYS_JTMS-SWDIO
PA14.Signal=SYS_JTCK-SWCLK
PA4.Signal=ADCx_IN4
PA5.Signal=ADCx_IN5
PA6.Signal=S_TIM3_CH1
PA7.Signal=S_TIM3_CH2
PB0.GPIO_Label=LD1 [Green]
PB0.Signal=GPIO_Output
PB14.GPIO_Label=LD3 [Red]
PB14.Signal=GPIO_Output
PB7.GPIO_Label=LD2 [Blue]
PB7.Signal=GPIO_Output
PC13.GPIO_Label=USER_Btn [B1]
PC13.Signal=GPXTI13
PD12.Signal=S_TIM4_CH1
PD13.Signal=S_TIM4_CH2
PD14.Signal=S_TIM4_CH3
PD8.Signal=USART3_TX
PD9.Signal=USART3_RX
PE8.Signal=TIM1_CH1N
PG0.GPIO_Label=Bumper_1
PG0.Signal=GPIO_Input
PG1.GPIO_Label=Bumper_2
PG1.Signal=GPIO_Input
PG6.GPIO_Label=USB_PowerSwitchOn [STMPS2151STR_EN]
PG6.Signal=GPIO_Output
PG7.GPIO_Label=USB_OverCurrent [STMPS2151STR_FAULT]
PG7.Signal=GPIO_Input
