SirBlaze10/Conversor-CC-CC-Buck-Boost-Interleaved/Código/Core/Inc/main.h

#define USER_Btn_Pin GPIO_PIN_13
#define USER_Btn_GPIO_Port GPIOC
#define USER_Btn_EXTI_IRQn EXTI15_10_IRQn
#define LD1_Pin GPIO_PIN_0
#define LD1_GPIO_Port GPIOB
#define Bumper_1_Pin GPIO_PIN_0
#define Bumper_1_GPIO_Port GPIOG
#define Bumper_2_Pin GPIO_PIN_1
#define Bumper_2_GPIO_Port GPIOG
#define LD3_Pin GPIO_PIN_14
#define LD3_GPIO_Port GPIOB
#define USB_PowerSwitchOn_Pin GPIO_PIN_6
#define USB_PowerSwitchOn_GPIO_Port GPIOG
#define USB_OverCurrent_Pin GPIO_PIN_7
#define USB_OverCurrent_GPIO_Port GPIOG
#define LD2_Pin GPIO_PIN_7
#define LD2_GPIO_Port GPIOB
