SirBlaze10/Conversor-CC-CC-Buck-Boost-Interleaved/Código/Core/Src/dac.c

/**
  ******************************************************************************
  * File Name          : DAC.c
  * Description        : This file provides code for the configuration
  *                      of the DAC instances.
  ******************************************************************************
  * @attention
  *
  * <h2><center>&copy; Copyright (c) 2021 STMicroelectronics.
  * All rights reserved.</center></h2>
  *
  * This software component is licensed by ST under BSD 3-Clause license,
  * the "License"; You may not use this file except in compliance with the
  * License. You may obtain a copy of the License at:
  *                        opensource.org/licenses/BSD-3-Clause
  *
  ******************************************************************************
  */

/* Includes ------------------------------------------------------------------*/
#include "dac.h"

DAC_HandleTypeDef hdac;
DMA_HandleTypeDef hdma_dac1;

/* DAC init function */
void MX_DAC_Init(void)
{
  DAC_ChannelConfTypeDef sConfig = {0};

  /** DAC Initialization
  */
  hdac.Instance = DAC;
  if (HAL_DAC_Init(&hdac) != HAL_OK)
  {
    Error_Handler();
  }
  /** DAC channel OUT1 config
  */
  sConfig.DAC_Trigger = DAC_TRIGGER_T7_TRGO;
  sConfig.DAC_OutputBuffer = DAC_OUTPUTBUFFER_DISABLE;
  if (HAL_DAC_ConfigChannel(&hdac, &sConfig, DAC_CHANNEL_1) != HAL_OK)
  {
    Error_Handler();
  }
  /** DAC channel OUT2 config
  */
  sConfig.DAC_Trigger = DAC_TRIGGER_NONE;
  sConfig.DAC_OutputBuffer = DAC_OUTPUTBUFFER_ENABLE;
  if (HAL_DAC_ConfigChannel(&hdac, &sConfig, DAC_CHANNEL_2) != HAL_OK)
  {
    Error_Handler();
  }

}

void HAL_DAC_MspInit(DAC_HandleTypeDef* dacHandle)
{

  GPIO_InitTypeDef GPIO_InitStruct = {0};
  if(dacHandle->Instance==DAC)
  {
    /* DAC clock enable */
    __HAL_RCC_DAC_CLK_ENABLE();

    __HAL_RCC_GPIOA_CLK_ENABLE();
    /**DAC GPIO Configuration
    PA4     ------> DAC_OUT1
    PA5     ------> DAC_OUT2
    */
    GPIO_InitStruct.Pin = GPIO_PIN_4|GPIO_PIN_5;
    GPIO_InitStruct.Mode = GPIO_MODE_ANALOG;
    GPIO_InitStruct.Pull = GPIO_NOPULL;
    HAL_GPIO_Init(GPIOA, &GPIO_InitStruct);

    /* DAC DMA Init */
    /* DAC1 Init */
    hdma_dac1.Instance = DMA1_Stream5;
    hdma_dac1.Init.Channel = DMA_CHANNEL_7;
    hdma_dac1.Init.Direction = DMA_MEMORY_TO_PERIPH;
    hdma_dac1.Init.PeriphInc = DMA_PINC_DISABLE;
    hdma_dac1.Init.MemInc = DMA_MINC_ENABLE;
    hdma_dac1.Init.PeriphDataAlignment = DMA_PDATAALIGN_WORD;
    hdma_dac1.Init.MemDataAlignment = DMA_MDATAALIGN_WORD;
    hdma_dac1.Init.Mode = DMA_CIRCULAR;
    hdma_dac1.Init.Priority = DMA_PRIORITY_LOW;
    hdma_dac1.Init.FIFOMode = DMA_FIFOMODE_DISABLE;
    if (HAL_DMA_Init(&hdma_dac1) != HAL_OK)
    {
      Error_Handler();
    }

    __HAL_LINKDMA(dacHandle,DMA_Handle1,hdma_dac1);

  }
}

void HAL_DAC_MspDeInit(DAC_HandleTypeDef* dacHandle)
{

  if(dacHandle->Instance==DAC)
  {
    /* Peripheral clock disable */
    __HAL_RCC_DAC_CLK_DISABLE();

    /**DAC GPIO Configuration
    PA4     ------> DAC_OUT1
    PA5     ------> DAC_OUT2
    */
    HAL_GPIO_DeInit(GPIOA, GPIO_PIN_4|GPIO_PIN_5);

    /* DAC DMA DeInit */
    HAL_DMA_DeInit(dacHandle->DMA_Handle1);
  }
}

/* USER CODE BEGIN 1 */
void My_DAC_function(uint16_t valor_D, uint8_t channel)
{
//while(HAL_DAC_GetState(&hadc) != HAL_DAC_STATE_READY);	//verifica se ja coiso
	
	if(channel==2)
	{
		if(HAL_DAC_GetState(&hdac) != HAL_DAC_STATE_READY)
		{
			HAL_DAC_Stop(&hdac, DAC_CHANNEL_2);
		}
		
		if(HAL_DAC_Start(&hdac, DAC1_CHANNEL_2) == HAL_OK)	//escreve no DAC
		{
			HAL_DAC_SetValue(&hdac, DAC1_CHANNEL_2, DAC_ALIGN_12B_R, valor_D);
		}
	}
	
}
/* USER CODE END 1 */

/************************ (C) COPYRIGHT STMicroelectronics *****END OF FILE****/
