SirBlaze10/Conversor-CC-CC-Buck-Boost-Interleaved/(notices)

Notices in the files:
Código/Core/Inc/main.h:
© Copyright (c) 2019 STMicroelectronics.
All rights reserved.
